excalbian/membrane-tester/README.md

# Membrane Switch Tester

A touch-screen tester for 4–8 pin membrane switches, built on the ESP32-2432S028R ("Cheap Yellow Display") with a PCF8574 I/O expander and an LVGL 9 UI.

It doesn't need to know the switch layout in advance. On every scan it drives each pin low in turn and records which other pins follow it, giving a full pin-to-pin connection map. That map is checked against a profile, so the same hardware handles:

- **Common-contact** switches: one shared pin, one pin per key
- **Matrix** switches: rows × columns
- **Unknown parts**: use **Learn** or **Pin monitor** to work out the pinout

| Test (pass) | Test (fail) | Learn |
| --- | --- | ----- |
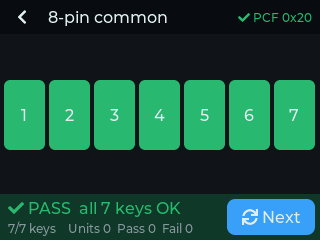
[picture p1: docs/test-pass.png]
test pass screenshot
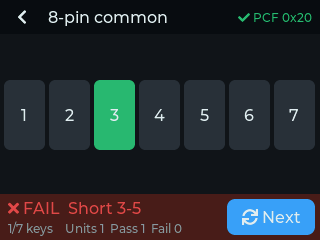
[picture p2: docs/test-fail.png]
test fail screenshot
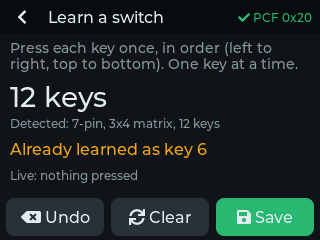
[picture p3: docs/learn.png]
learn screenshot
|  |  |  |
| **Home** | **Pin monitor** | **Template builder** |
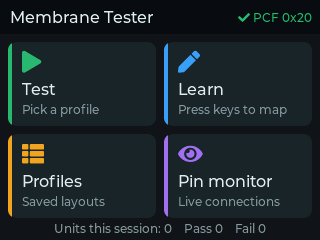
[picture p4: docs/home.png]
home screenshot
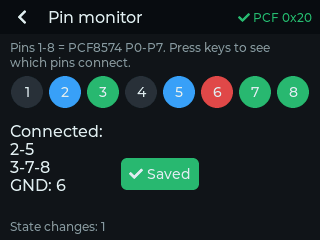
[picture p5: docs/pin-monitor.png]
pin monitor screenshot
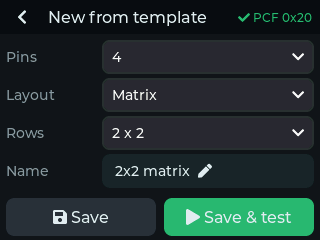
[picture p6: docs/template.png]
template screenshot
|  |  |  |

Note *screenshots come from the real UI code running in a desktop LVGL simulator.*

---

## Hardware

### Parts

- ESP32-2432S028R (2.8" ILI9341 + XPT2046 resistive touch)
- PCF8574 or PCF8574A module (the blue breakout boards with address jumpers work fine)
- A connector that fits your membrane tails: 2.54 mm female header, a ZIF/FFC breakout, or a clincher connector wired to a header
- Optional: 8 × 220–330 Ω series resistors between the PCF8574 and the switch connector (protects the expander if you probe something powered)
- Optional: a speaker for audio feedback on key presses, passes, and faults

### Wiring

The CYD's **CN1** connector (4-pin JST 1.25 mm, labelled on the back of the board) carries two free GPIOs:

| CN1 pin | Connect to. |
| --- | --- |
| GND | PCF8574 GND |
| IO22 | PCF8574 **SCL** |
| IO27 | PCF8574 **SDA** |
| 3V3 | PCF8574 VCC |

```text
 PCF8574            Membrane switch tail
 P0  ─────────────  pin 1
 P1  ─────────────  pin 2
 P2  ─────────────  pin 3
 ...                ...
 P7  ─────────────  pin 8
```

- **Power the PCF8574 from 3.3 V**, not 5 V.
- Leave unused P-pins unconnected. A 4-pin switch uses P0–P3.
- **No pull-up resistors on P0–P7.** The PCF8574's built-in weak pull-ups are what the scan relies on. Most modules already have pull-ups on SDA/SCL.
- Address: any of 0x20–0x27 (PCF8574) or 0x38–0x3F (PCF8574A) is found automatically. The header shows `✓ PCF 0x20` when it's detected.
- Optional extras on the CYD: a small speaker on the **SPEAK** connector beeps on key presses, passes and faults, and the on-board RGB LED lights green on PASS and red on FAIL.

Pin numbers in the UI (1–8) always mean **PCF8574 P0–P7**. Wire switch pin 1 to P0 and the numbers will match the datasheet.

### Electrical notes

- **Contact resistance:** a key reads as closed if it pulls the other pin below ~1 V against the PCF8574's ~100 µA pull-up. That means contacts below ~3 kΩ always register and up to ~10 kΩ usually do. That covers silver and carbon membranes. A key that intermittently fails may be a high-resistance contact, which is a real defect.
- **Diodes:** switches with isolation diodes still work because the scan tests both directions.
- **Ghosting:** in a matrix without diodes, holding 3 keys can make a 4th look pressed. The tester only credits a key when it is the *only* key closed, and shows "One key at a time" otherwise.

### Optional Case

You can 3D print or otherwise fabricate a case to hold the ESP32-2432S028R, PCF8574 module, and membrane switch connector. Ensure the display and touch panel are accessible, and provide openings for the connectors and any optional speaker or RGB LED. I've included a basic 3D-printable design in the [case/](case/) directory as a starting point.

---

## Building and flashing

```bash
pio run -t upload          # build + flash
pio device monitor         # serial log (touch calibration values, PCF8574 status)
```

If the colors look inverted (common on the dual-USB board revision), use `pio run -e cyd_inverted -t upload`. If the picture is garbled rather than just inverted, see the note in `platformio.ini` about the ST7789 driver.

### Versioning

The firmware version is defined in [`include/version.h`](include/version.h) using `MAJOR.MINOR.PATCH` semantic versioning. Increase the patch for compatible fixes, the minor version for backward-compatible features, and the major version for incompatible changes. The home-screen header displays this version.

#### Pull requests and prereleases

1. Make changes on a branch and open a pull request. Every PR, including documentation-only changes, must increase `APP_VERSION` in `include/version.h` above the base branch's version. The **Version bump** check fails for unchanged, lower, missing, or invalid versions. If the base branch does not yet have a version file, introducing a valid version satisfies the check. Update your branch and version if another PR merges with the same version first.
2. Build both variants locally with `pio run -e cyd -e cyd_inverted`. PRs run the version check but do not build or publish firmware. To block merging when the check fails, configure **Version bump** as a required status check in the target branch's protection rules or ruleset.
3. Merge the PR into `main`. The resulting push builds both variants and publishes a prerelease tagged `v<version>-build.<run>.<attempt>`, for example `v1.1.0-build.42.1`.
4. Wait for the workflow to succeed and test the prerelease firmware on hardware before publishing a stable release.

#### Publishing a stable release

1. Ensure the intended changes and version bump are merged into `main`.
2. With a clean working tree, update your local `main` and confirm `APP_VERSION` in `include/version.h`.
3. Tag the tested release commit and push only that tag. For example, if `APP_VERSION` is `1.2.0` and the latest `main` commit is the tested commit:

   ```bash
   git switch main
   git pull --ff-only origin main
   git tag v1.2.0
   git push origin v1.2.0
   ```

   If `main` has advanced since testing, tag the tested commit explicitly with `git tag v1.2.0 <tested-commit-sha>` instead.

4. The tag push rebuilds both variants and publishes a stable GitHub release with the firmware assets. The tag must exactly match `v<APP_VERSION>`; a mismatch fails the workflow.
5. Confirm the workflow succeeded and the release contains both variants. Do not move or reuse published version tags; publish a new version for subsequent fixes.

### Prebuilt firmware

Every push to `main` builds both `cyd` and `cyd_inverted` with PlatformIO and publishes a new [GitHub prerelease](https://github.com/excalbian/membrane-tester/releases) after both builds succeed. Pushing a version tag (`v<version>`) publishes a stable release; the workflow checks that the tag matches `APP_VERSION`. All releases point to the commit that was built.

Each release includes standalone `membrane-tester-<variant>.bin` firmware and complete `membrane-tester-<variant>-merged.bin` images containing the bootloader, partition table, and firmware. Use `cyd_inverted` if your display has inverted colors.

Both stable releases and prereleases automatically include a GitHub-generated changelog with merged pull requests, contributors, and a full comparison link. GitHub selects the previous release as the comparison baseline. Firmware flashing instructions remain at the top of the release notes; no manual changelog file is required.

To install a merged image, you can either use `esptool` (requires python and installing esptool) or the espressif web tool. `membrane-tester-<variant>-merged.bin` is a complete image (bootloader, partitions and app) suitable for loading with the espressif web tool or `esptool`.

#### Option A: flash with esptool

install esptool (`python -m pip install esptool==4.5.1`), connect the board, and flash at address `0x0` (replace the port and filename as needed):

```bash
python -m esptool --chip esp32 --port /dev/ttyUSB0 write_flash 0x0 membrane-tester-cyd-merged.bin
```

Standalone firmware is flashed at `0x10000` and requires the matching bootloader and partition table to already be installed.

#### Option B: flash the prebuilt image, nothing to install

1. Open <https://espressif.github.io/esptool-js/> in Chrome or Edge
1. Connect, choose the CYD's serial port, and set the flash address to **0x0**
1. Program `membrane-tester-cyd-merged.bin`

---

## Using it

### Home

Four tiles: **Test**, **Learn**, **Profiles**, **Pin monitor**. The footer shows this session's unit count and pass/fail totals.

### Profiles

A profile is a named list of keys, where each key is a pair of pins. Five templates are created on first boot: 4-, 5- and 8-pin common (common on pin 1), 3×4 matrix (7 pins) and 4×4 matrix (8 pins). Tap a profile to **Test** or **Delete** it (tap Delete twice to confirm).

**+ Template** builds a standard layout from:

- Pin count (4–8)
- Layout: common contact or matrix
- The common pin, or the row/column split (rows are the first N pins)

The last profile used is remembered across power cycles. Profiles are stored in flash (NVS), up to 20.

### Learn: for anything non-standard

1. Connect the switch and open **Learn**
2. Press each key once, **in order**: left to right, top to bottom
3. The screen confirms each key ("Key 5 = pins 2–6") and detects the layout as you go: common, R×C matrix, or custom
4. **Save** asks for a name (the part number works well) and goes straight to Test

Learn catches mistakes: pressing a key twice shows "Already learned as key N", and a press that connects more than two pins is rejected. **Undo** removes the last key. Because keys are stored in the order you press them, the Test grid matches the physical layout.

### Test: production use

1. Connect the unit. If anything is connected at rest, it's flagged immediately as a short or stuck key.
2. Press every key. Tiles turn **blue** while held and **green** once tested.
3. When every key is green and nothing unexpected happened, you get **PASS**, a beep and a green LED.
4. Any connection the profile doesn't explain gives **FAIL** with the reason, e.g. `Short 3-5`, `Key 2 stuck`, `Pin 4 to GND`.
5. Tap **Next** for the next unit. A unit counts as tested if any key was pressed or a fault was seen, and as passed only on a full PASS. An incomplete unit counts as a fail.

### Pin monitor: reverse-engineering

Live view of all 8 pins. Pins that are connected to each other share a colour, and a pin shorted to ground shows red. The text lists each connected group ("2-5", "3-7-8"). Press keys one at a time to map an unknown tail. The "state changes" counter helps spot flaky contacts.

---

## Simulator

The simulator allows you to run the membrane switch tester on a desktop environment using SDL2. It simulates the PCF8574 I/O expander, with the mouse acting as the touchscreen and the keyboard as the membrane switch under test. More details are available in the [sim](sim) directory.

---

## Configuration (`src/config.h`)

| Setting | Default | Notes |
| --- | --- | --- |
| `I2C_FREQ` | 100000 | PCF8574 spec. 400000 usually works and scans 4× faster |
| `DEBOUNCE_SCANS` | 4 | Identical scans needed to accept a change (~16–20 ms) |
| `SCAN_INTERVAL_MS` | 4 | Time between scans |
| `TOUCH_X/Y_MIN/MAX` | 200/3700, 240/3800 | Touch calibration. Every touch prints raw values to serial |
| `TOUCH_INVERT_X/Y`, `TOUCH_SWAP_XY` | 0 | If taps land mirrored or rotated |
| `TFT_ROTATION` | 1 | Landscape, USB on the right. 3 flips it |
| `ENABLE_BEEP` | 1 | Set 0 to silence the speaker |

### Troubleshooting

- **"No PCF8574" in the header:** check SDA/SCL (they're easy to swap), confirm 3.3 V on the module, and run the serial monitor. The tester re-probes every second, so you can fix the wiring without rebooting.
- **Taps land in the wrong place:** touch the four corners, read the raw x/y values in the serial monitor, and update `TOUCH_*` in `config.h`.
- **Every key shows as a short to the next one:** the cable or connector is probably bridging adjacent pins. Check with Pin monitor with no switch connected. Nothing should light up.

---

## Code layout

``` text
src/config.h     pins, calibration, timing
src/model.*      PCF8574 scanner + debounce, profiles (NVS), test & learn logic
src/ui.*         LVGL screens
src/main.cpp     TFT_eSPI / XPT2046 / LVGL glue, beeper + LED
include/lv_conf.h
```

Libraries: LVGL 9.2.2, TFT_eSPI 2.5.43, XPT2046_Touchscreen. Arduino-ESP32 core 2.0.17 (espressif32 platform 6.9.0).

## Other files

- `docs/` contains screenshots and other documentation assets.
- `case/` contains files related to the physical case of the tester
- `sim/` contains the desktop simulator for the tester
