excalbian/membrane-tester/case/membrane_tester_tray.stl

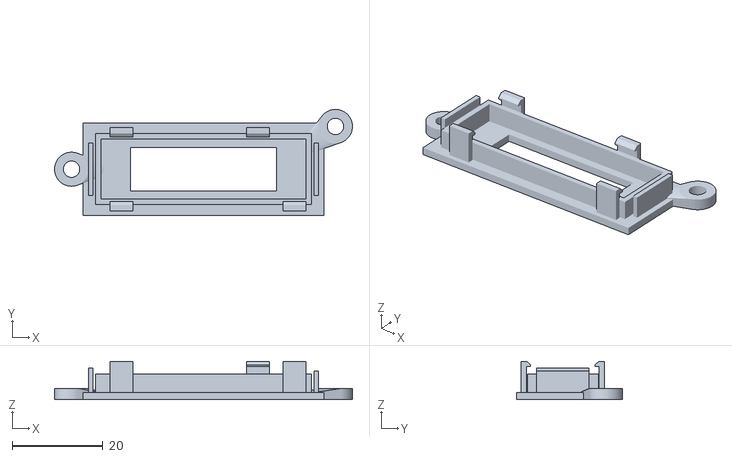
[picture p8: CAD file, 2026-11-01]
case/membrane_tester_tray.stl
65.5 x 23.3 x 8.40
