excalbian/membrane-tester/case/membrane_tester_fit_test.stl

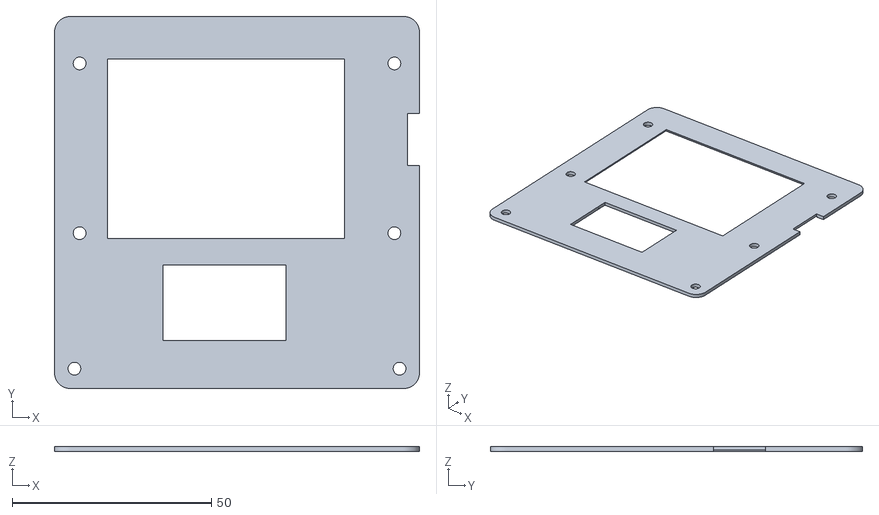
[picture p9: CAD file, 2026-11-01]
case/membrane_tester_fit_test.stl
91.6 x 93.4 x 1.20
