excalbian/membrane-tester/case/membrane_tester_bezel.stl

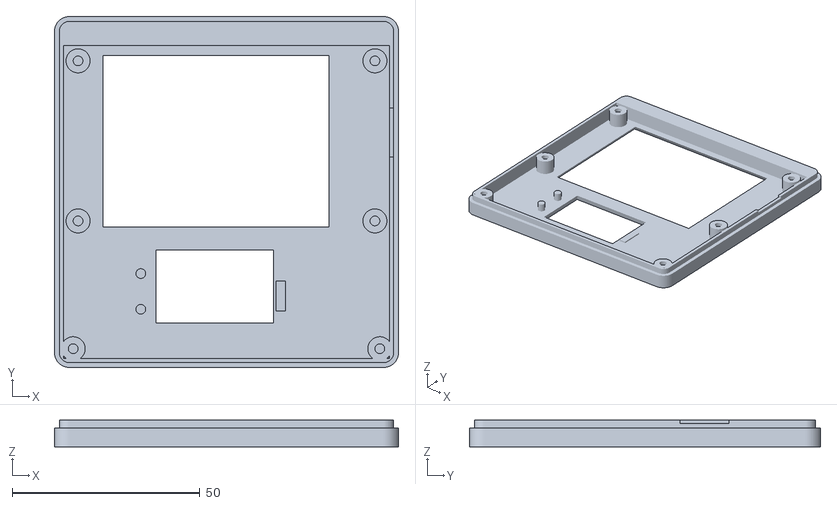
[picture p10: CAD file, 2026-11-01]
case/membrane_tester_bezel.stl
91.6 x 93.4 x 7.10
