excalbian/membrane-tester/case/membrane_tester_base.stl

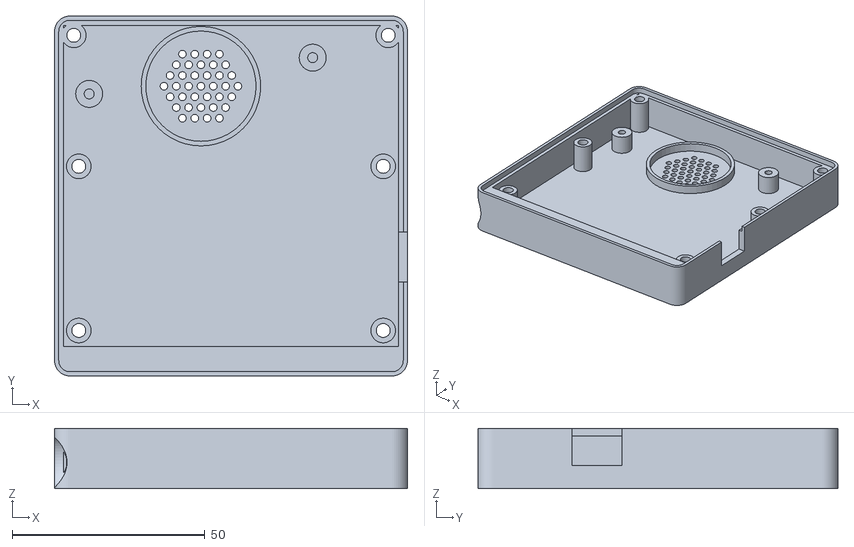
[picture p11: CAD file, 2026-11-01]
case/membrane_tester_base.stl
91.6 x 93.4 x 15.6
