excalbian/membrane-tester/docs/test-matrix.png

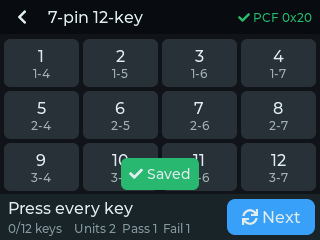
docs/test-matrix.png
