excalbian/membrane-tester/(commit log)

2026-11-01 Initial version
    [membrane_tester_base.stl, membrane_tester_bezel.stl, membrane_tester_case.scad]
2026-11-01 feat: new case design
    [membrane_tester_base.stl, membrane_tester_bezel.stl, membrane_tester_case.scad, membrane_tester_fit_test.stl]
2026-11-01 feat: updated case so HW-171 doesn't have to be modified
    [membrane_tester_base.stl, membrane_tester_bezel.stl, membrane_tester_case.scad, membrane_tester_fit_test.stl, membrane_tester_tray.stl]
